PadillaPepe777/Den-Den-Mushi-ESP-NOW/README.md

# Den-Den-Mushi-ESP-NOW
This is a project to develop a Walkie-Talkie Based on the Den Den Mushi Snail Cellphones from One Piece
The things required for this project are obviously for it to function as a common Walkie Talkie would, 
but using the ESP NOW protocol for it's simplicity. Here we could call it a day and just put in in a 
case that reseambles a Den Den Mushi, but the goal is for it to feel "Alive"

The Snail must open and close its eyes as if it was blinking, this with the help of a 
simple mechanism and Servo motor. Apart from this, it needs to open and close the mouth as
it's reproducing the audio from the call

Materials:
ESP32 WROOM 38 pins (should work with other models)

INMP441 I2S Microphone ADC

PCM5102A I2S DAC
(Must have solder in the joints as shown in the nest image)


Amplifier circuit (With OPAMP LM386)

Speaker

PCB for manufacture

Servo Motors
3D prints

Also including a BMS circuit, step down and linear regulator for servvos, speaker and mcirocontrollers

And 2 Li-on batteries

Progress at Janurary 24th 2026
IRL1
IRL2
PCBS

Final first Prototype photo (I will attach a link to my YouTube Video about it to demostrate it's functionality

DenDenMushi_FinalForm

https://youtu.be/OOOR9_c7WgU?si=kHnlmn8EDtVqr4cH

I will be happy to receive feedback or questions, Thank you so much for Being Here
