PadillaPepe777/Den-Den-Mushi-ESP-NOW/Basic Walkie-Talkie/Conexiones.png

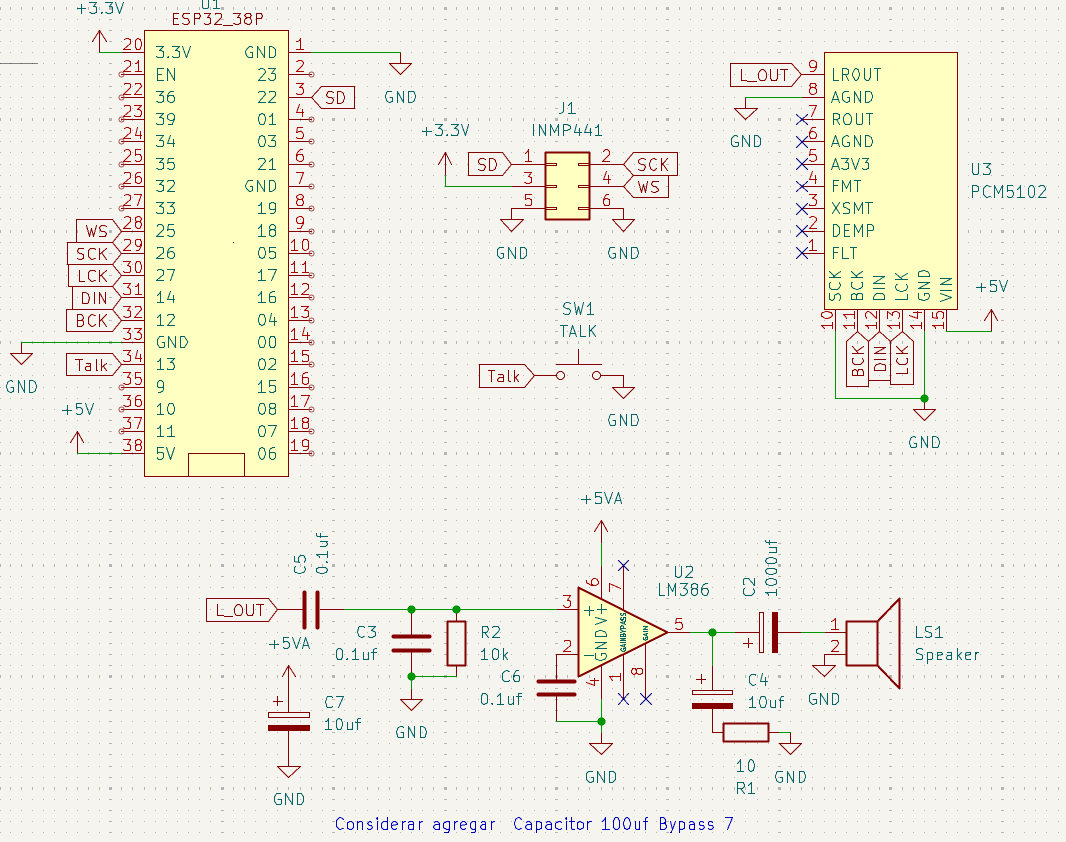
Basic Walkie-Talkie/Conexiones.png
