PadillaPepe777/Den-Den-Mushi-ESP-NOW/V1.0 FILES.M/Screenshot 2026-03-05 013004.png

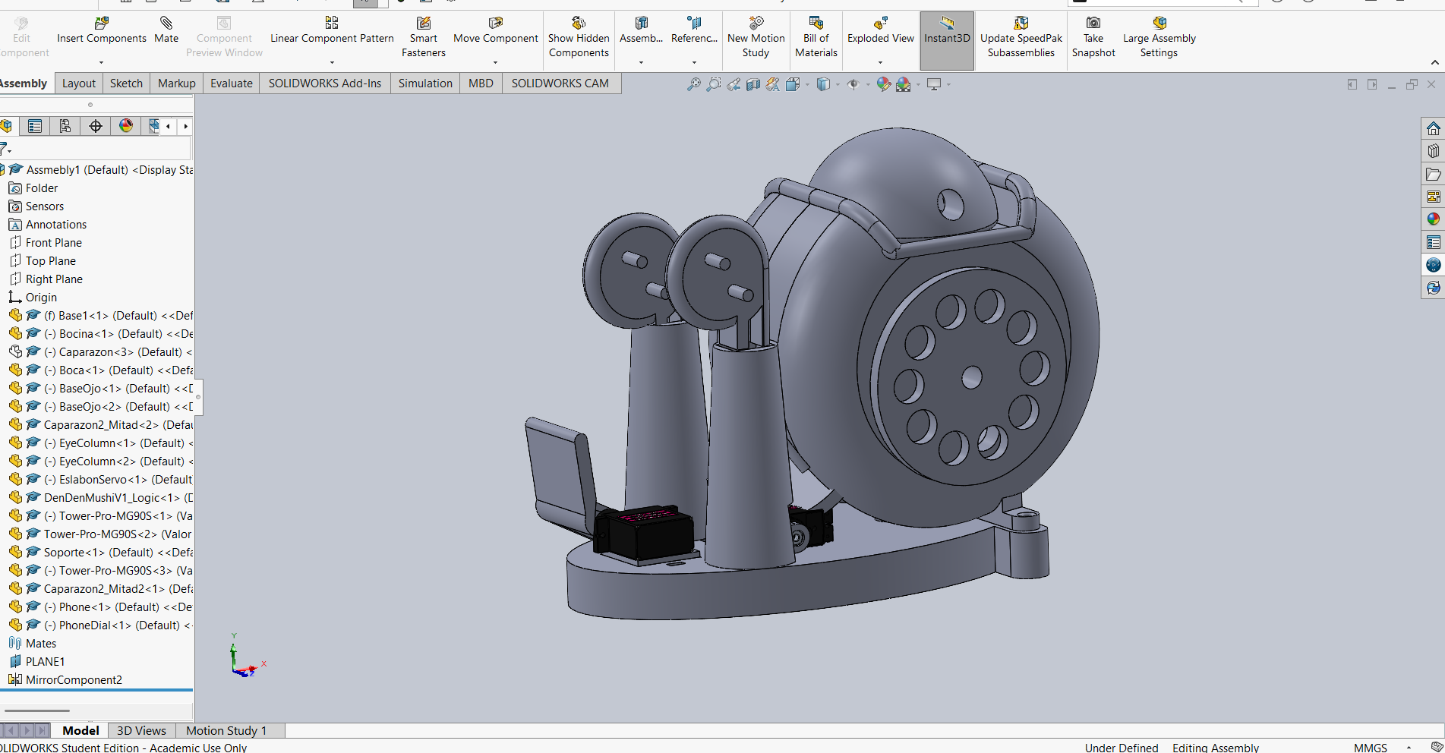
V1.0 FILES.M/Screenshot 2026-03-05 013004.png
