PadillaPepe777/Den-Den-Mushi-ESP-NOW/V1.0 FILES.M/Screenshot 2026-03-06 143330.png

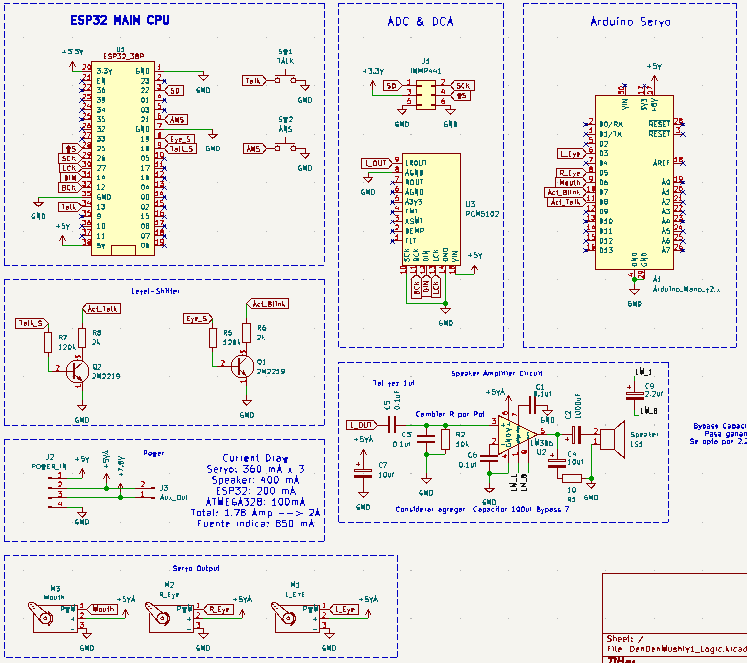
V1.0 FILES.M/Screenshot 2026-03-06 143330.png
