PadillaPepe777/Den-Den-Mushi-ESP-NOW/3D MODEL/1stTrial_Assembly.png

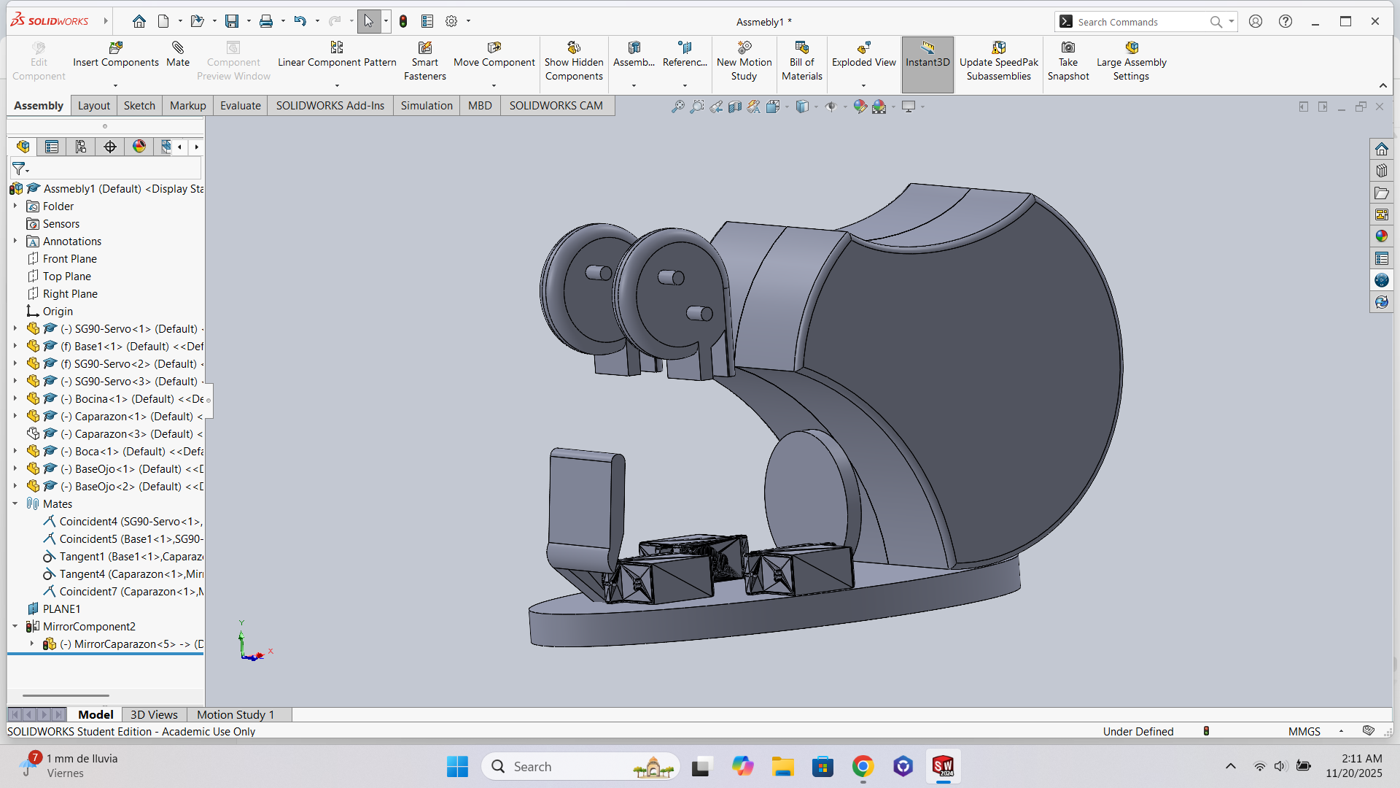
3D MODEL/1stTrial_Assembly.png
