PadillaPepe777/Den-Den-Mushi-ESP-NOW/3D MODEL/2ndTrial_Assembly.png

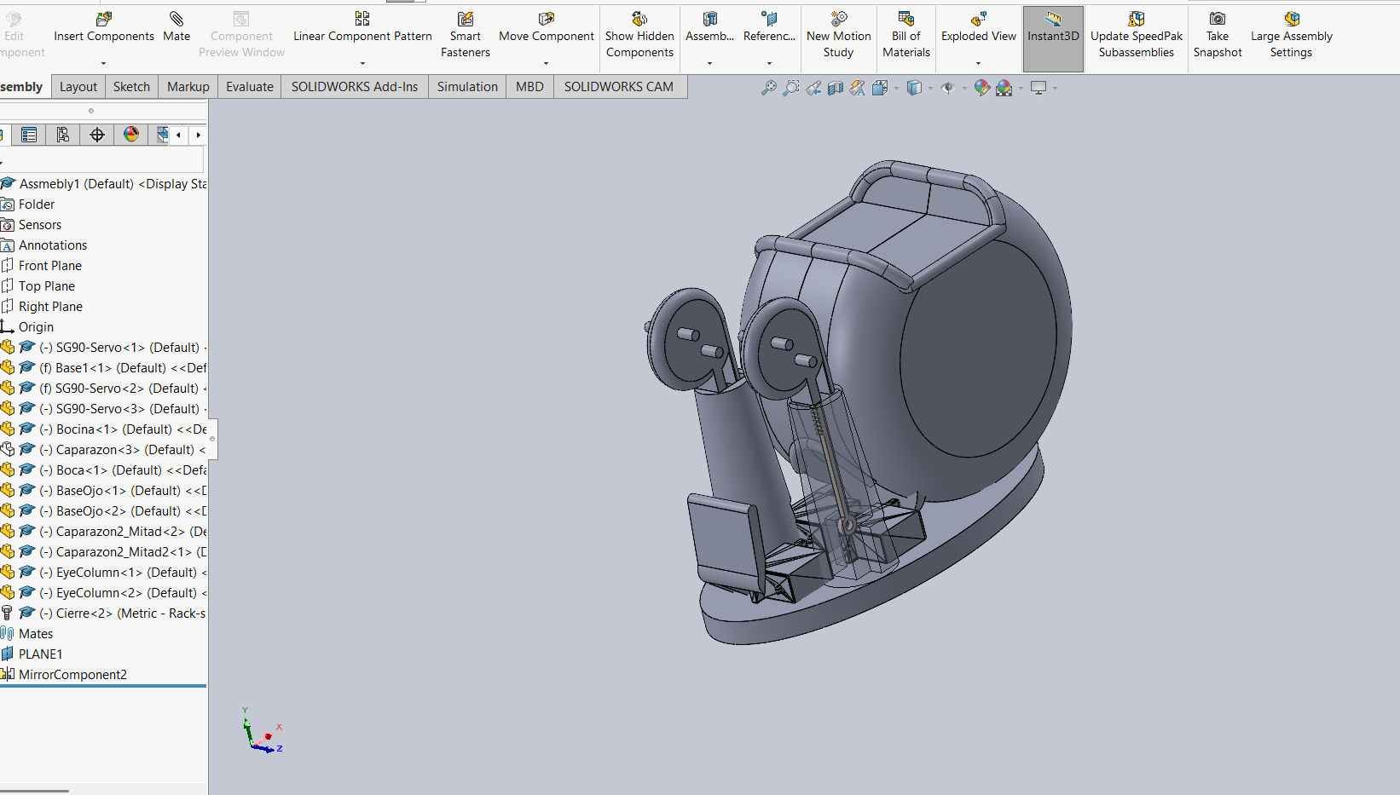
3D MODEL/2ndTrial_Assembly.png
