PadillaPepe777/Den-Den-Mushi-ESP-NOW/3D MODEL/Eye Mechanism Assembly.png

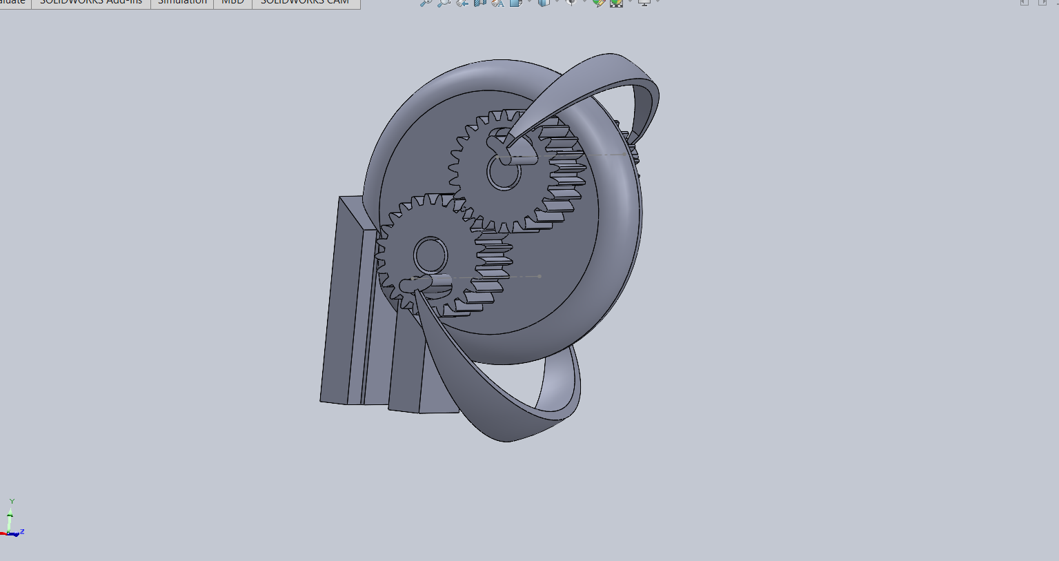
3D MODEL/Eye Mechanism Assembly.png
