PadillaPepe777/Den-Den-Mushi-ESP-NOW/V1.0 FILES.M/Arduino & ESP32/denden_sound.h

#ifndef SOUND_DENDEN_H
#define SOUND_DENDEN_H

const unsigned char denden_wav[] = {
0x52, 0x49, 0x46, 0x46, 0xAE, 0xB1, 0x00, 0x00, 0x57, 0x41, 0x56, 0x45, 0x66, 0x6D, 0x74, 0x20, 0x10, 0x00, 0x00, 0x00, 0x01, 0x00, 0x01, 0x00, 0x80, 0x3E, 0x00, 0x00, 0x00, 0x7D, 0x00, 0x00, 0x02, 0x00, 0x10, 0x00, 0x64, 0x61, 0x74, 0x61, 0x60, 0xB1, 0x00, 0x00, 0xFF, 0xFF, 0x01, 0x00, 0xFF, 0xFF, 0x05, 0x00, 0x02, 0x00, 0x03, 0x00, 0xFF, 0xFF, 0x00, 0x00, 0x04, 0x00, 0xFF, 0xFF, 0x02, 0x00, 0xFD, 0xFF, 0x09, 0x00, 0xFF, 0xFF, 0x03, 0x00, 0xF9, 0xFF, 0xFD, 0xFF, 0xFC, 0xFF, 0xFF, 0xFF, 0xF9, 0xFF, 0x02, 0x00, 0xFE, 0xFF, 0x06, 0x00, 0x03, 0x00, 0x01, 0x00, 0x04, 0x00, 0xFE, 0xFF, 0x05, 0x00, 0x00, 0x00, 0x03, 0x00, 0xFD, 0xFF, 0x02, 0x00, 0xFC, 0xFF, 0x00, 0x00, 0xFD, 0xFF, 0x00, 0x00, 0xFE, 0xFF, 0x01, 0x00, 0xFF, 0xFF, 0x03, 0x00, 0x00, 0x00, 0x04, 0x00, 0x01, 0x00, 0x04, 0x00, 0x01, 0x00, 0x03, 0x00, 0x01, 0x00, 0x00, 0x00, 0x00, 0x00, 0x03, 0x00, 0xFD, 0xFF, 0x03, 0x00, 0xFE, 0xFF, 0x02, 0x00, 0x02, 0x00, 0xFD, 0xFF, 0x03, 0x00, 0xFA, 0xFF, 0x05, 0x00, 0xFB, 0xFF, 0x03, 0x00, 0xF9, 0xFF, 0x02, 0x00, 0xFE, 0xFF, 0x03, 0x00, 0x00, 0x00, 0x04, 0x00, 0xFF, 0xFF, 0x02, 0x00, 0xFB, 0xFF, 0x04, 0x00, 0xFE, 0xFF, 0xFF, 0xFF, 0x02, 0x00, 0xFC, 0xFF, 0xFF, 0xFF, 0x00, 0x00, 0xFF, 0xFF, 0x04, 0x00, 0xFD, 0xFF, 0x00, 0x00, 0x00, 0x00, 0xFF, 0xFF, 0x01, 0x00, 0xFE, 0xFF, 0x02, 0x00, 0xFD, 0xFF, 0x00, 0x00, 0xFF, 0xFF, 0x01, 0x00, 0x05, 0x00, 0x02, 0x00, 0x05, 0x00, 0xFE, 0xFF, 0x04, 0x00, 0xFA, 0xFF, 0x01, 0x00, 0xF9, 0xFF, 0x03, 0x00, 0xFF, 0xFF, 0x01, 0x00, 0xFE, 0xFF, 0xFF, 0xFF, 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
