PadillaPepe777/Den-Den-Mushi-ESP-NOW/(commit log)

2025-11-08 README with project details and materials
    Expanded project description and listed required materials.
2025-11-08 Add files via upload
    Sender and Receiver, help of Chat GPT to filter the signal, and some trial and error with different variables until reaching the desired Quality
    [Receiver_GPT2.ino, Sender_GPT2.ino]
2025-11-08 README
    Added additional components to the materials list.
2025-11-08 Add files via upload
    File to test the INMP441 microphone working correctly, saves audio record to SD card
    [Tester_SD.ino]
2025-11-13 Add files via upload
    Diagrama con Integrado LM386 para amplificador
2025-12-11 Eye Mechanism Assembly
2025-12-11 Rename Screenshot 2025-12-11 153055.png to Eye Mechanism Assembly
2026-01-14 Revise README with updated components and details
    Updated component names and added details about soldering, amplifier circuit, PCB, and additional circuits.
2026-01-15 Add README with project overview and future plans
    Added details about the electronic schematics, manufacturing choices, and future plans for assembly instructions.
2026-01-15 Add files via upload
    Gerbers sent for manufacture of the PCBs for both power and logic
2026-01-15 Kicad PCB Files
2026-03-06 Add files via upload
    DenDenMushiV1.0 Power Board, with a BMS, step Down and 7805 linear 5V Regulator
2026-03-06 Add files via upload
    Logic Board Gerber files, with Schematic ScreenShot
    Uses an Arduino Nano and an ESP32 WROOM 38 pins
2026-03-06 Add files via upload
    STL Files to use on your 3D printer
2026-03-30 Update README with final prototype photo and video link
    Added a photo of the final prototype and a YouTube link demonstrating its functionality.
